GlowDuino/GlowDuino/Uno/Images/IMG_0 (3).JPG

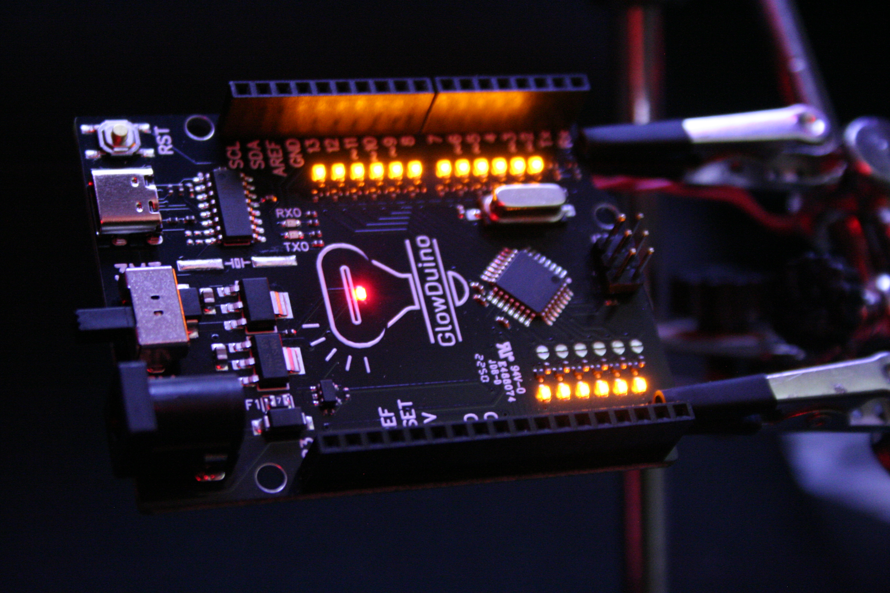
Uno/Images/IMG_0 (3).JPG
