GlowDuino/GlowDuino/Uno/Images/IMG_0 (5).JPG

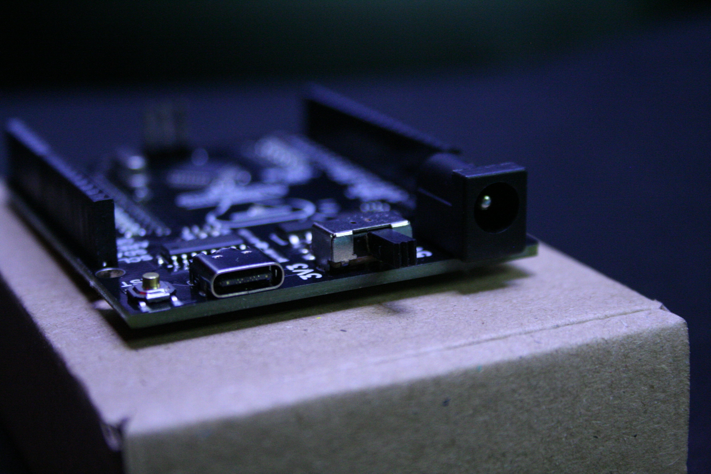
Uno/Images/IMG_0 (5).JPG
