GlowDuino/GlowDuino/Uno/README.md

## UNO Boards

To find more information about your board, reference the version number on the underside 
of your board and open the information folder accordingly!

### General feature overview

- Atmeg 328PB microcontroller
    - 32KB Flash memory
    - 2KB SRAM
    - 1KB EEPROM
    - 16MHz external crystal oscillator
    - 5 Internal timers
    - Preloaded Arduino IDE- compatible bootloader
- 24 GPIO pins
    - 40mA GPIO current
    - 8 Analog inputs (A0- 7)
    - 9 PWM outputs	(0,1,2,3,5,6,9,10,11)
    - 2 Serial ports (0,1, 11,12)
    - 2 I²C interfaces (A5,A4, 22,23)
    - 2 SPI interfaces (10,11,12,13, A0,A1,A6,A7)
- Switchable GPIO voltage (5V, 3.3V)
- High power 5V and 3.3V rail
    - 1A Max
- 20 GPIO indicator LEDs
    - 665K MAX input resistance
- CH340 USB- Serial converter (Serial 0)
- 6pin ICSP header for direct programming
- USB Type- C connector (for programming)
- Power jack (for additional power)
    - Recommended voltage range: 7-12V
    - Maximum voltage range: 6-20V
