GlowDuino/GlowDuino/Uno/v1.7/Bootloader/optiboot/README.txt

We build the bootloaders for the GlowDuino boards using WinAVR-201001110.
