GlowDuino/GlowDuino/Uno/Images/IMG_0 (1).JPG

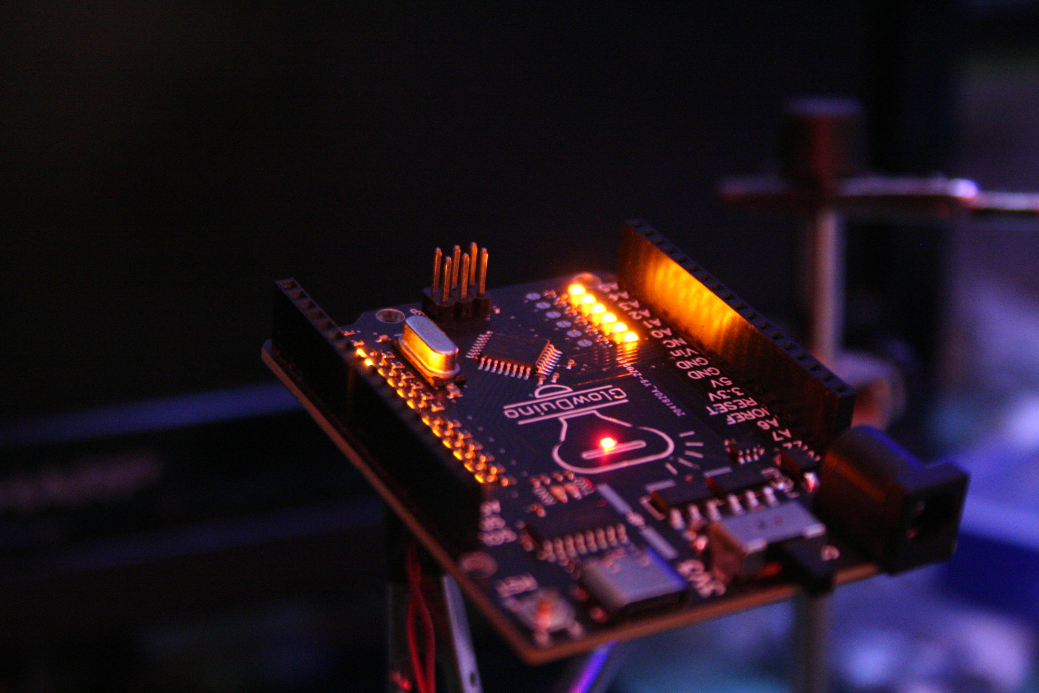
Uno/Images/IMG_0 (1).JPG
