GlowDuino/GlowDuino/Uno/Images/IMG_0 (2).JPG

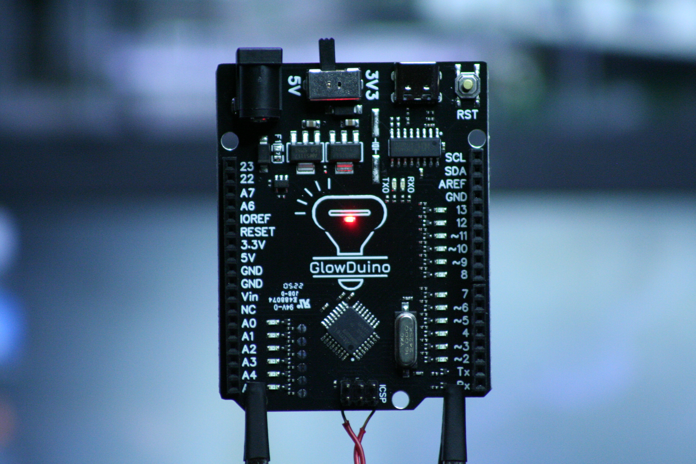
Uno/Images/IMG_0 (2).JPG
