GlowDuino/GlowDuino/Uno/Images/IMG_0 (4).JPG

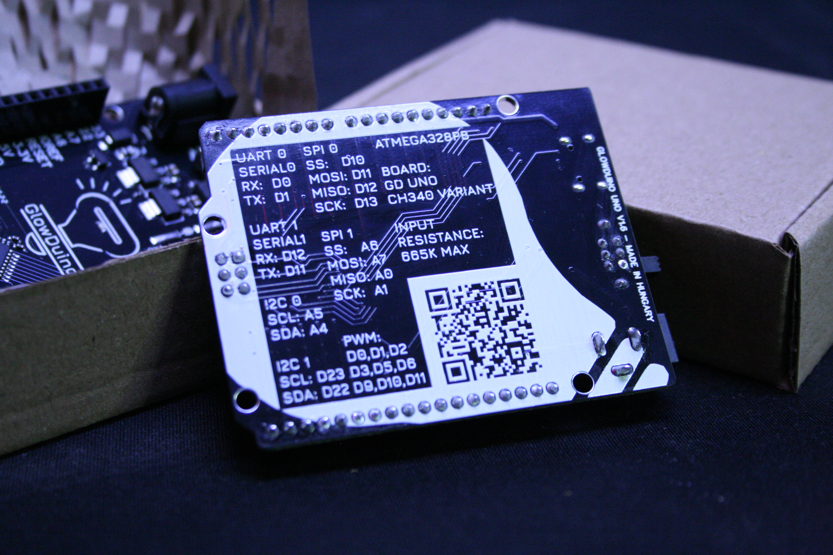
Uno/Images/IMG_0 (4).JPG
