GlowDuino/GlowDuino/Uno/Pinout-UnoV1.6.png

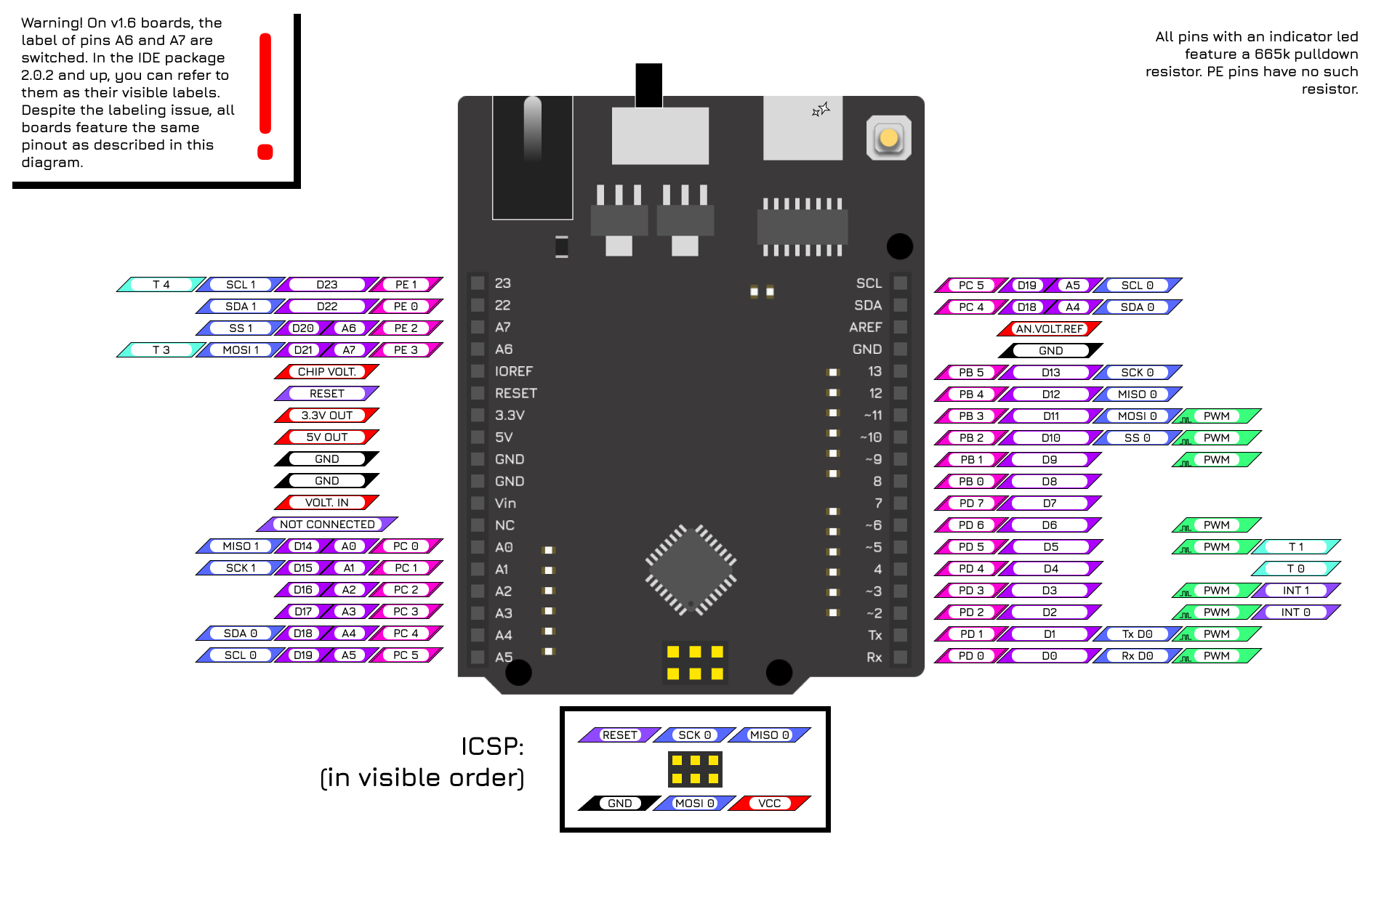
Uno/Pinout-UnoV1.6.png
