GlowDuino/GlowDuino/Uno/Pinout-UnoV1.7 and above.png

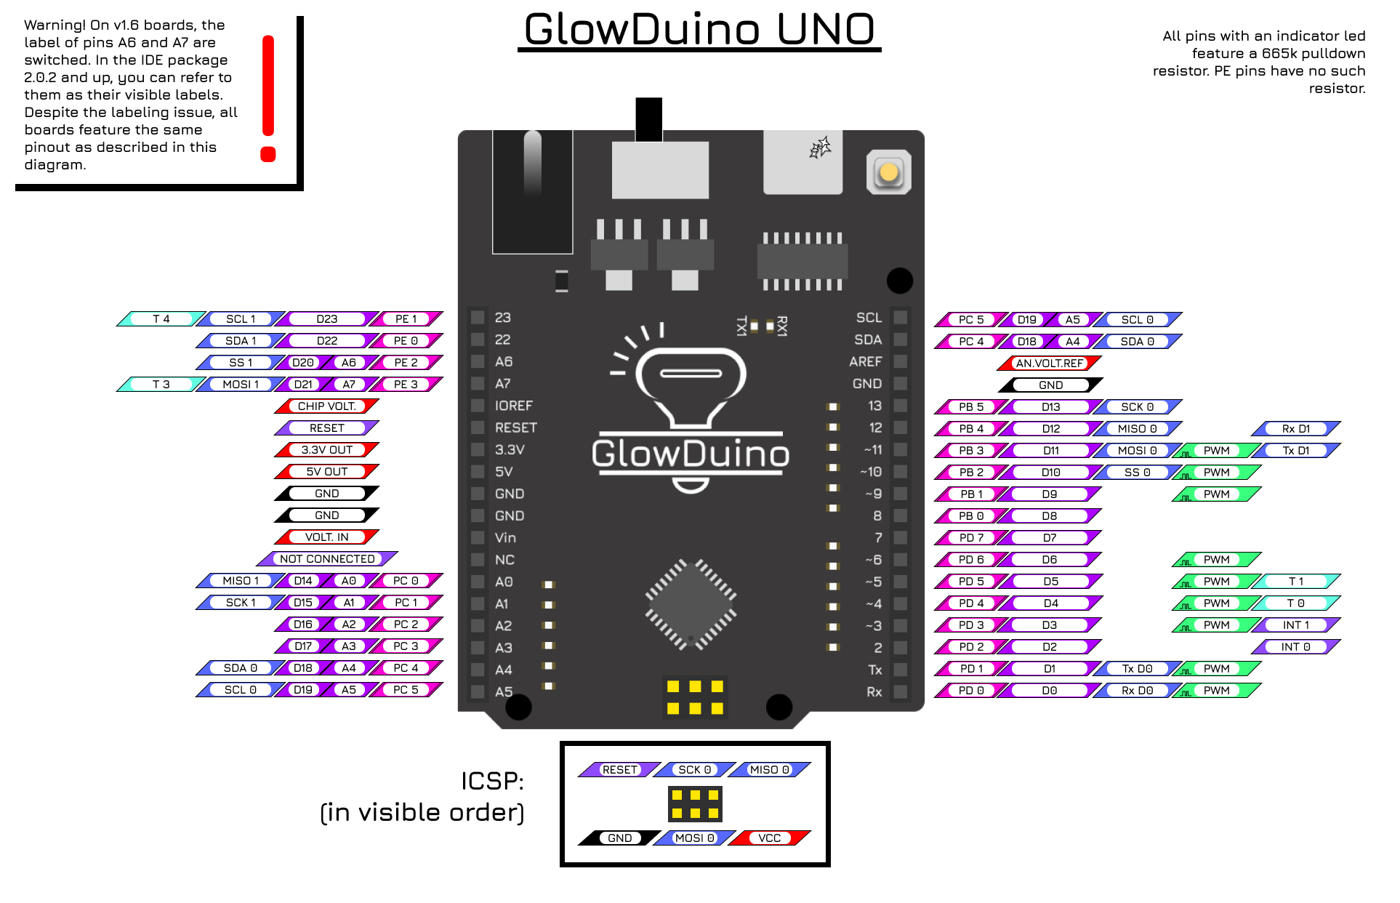
Uno/Pinout-UnoV1.7 and above.png
