GlowDuino/GlowDuino/Uno/v1.7/v1.7_Schematic.png

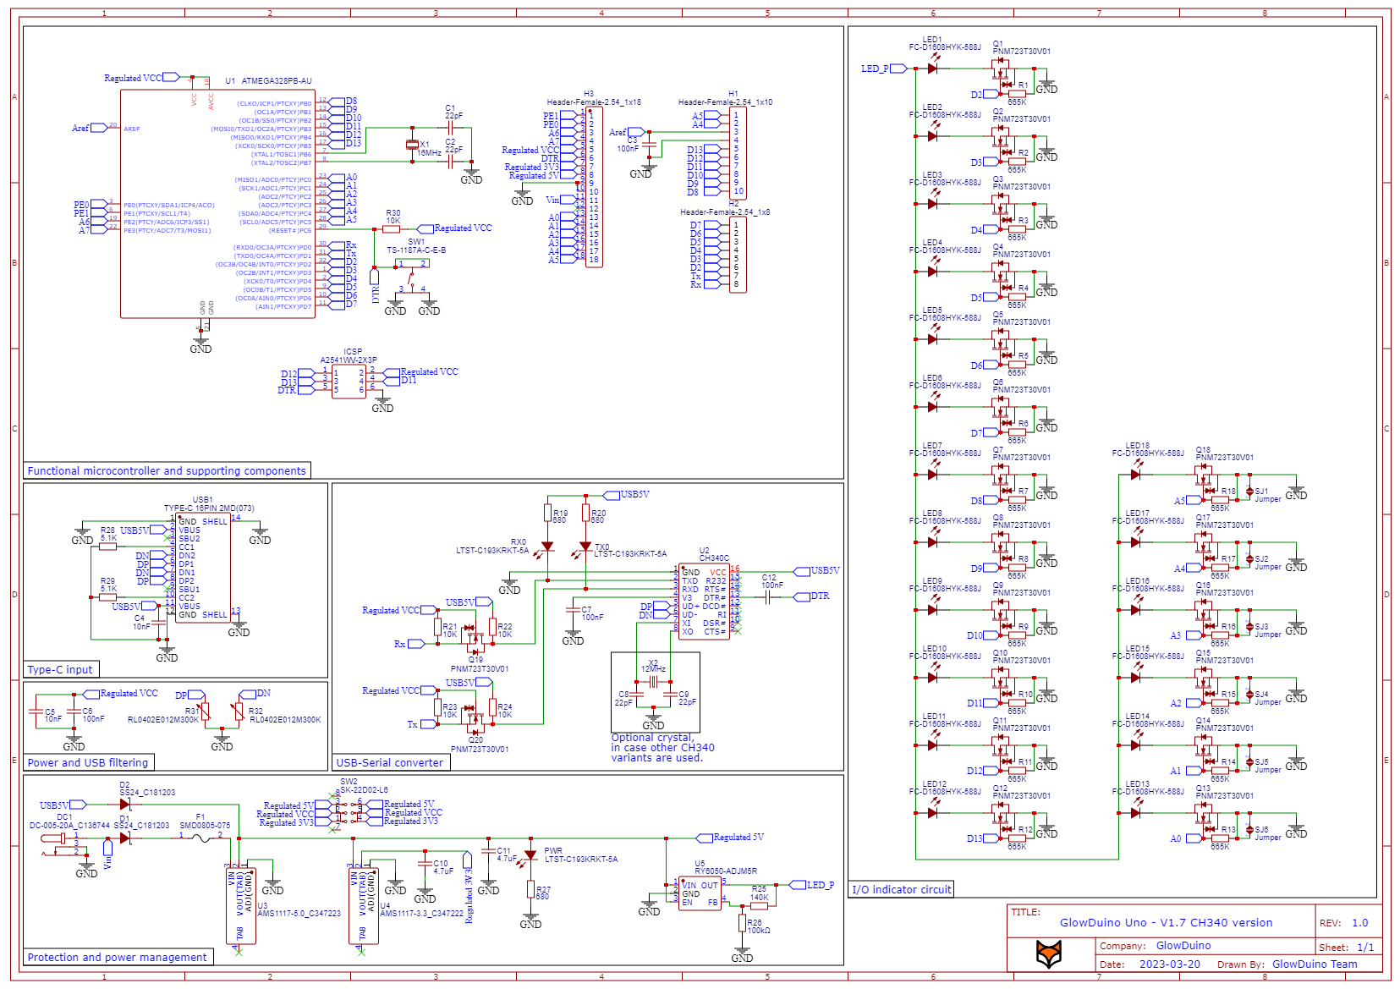
Uno/v1.7/v1.7_Schematic.png
