GlowDuino/GlowDuino/Uno/v1.7/Pin Definitions for C/pins_arduino.h

/*
  pins_arduino.h - Pin definition functions for Arduino
  Part of Arduino - http://www.arduino.cc/

  Copyright (c) 2007 David A. Mellis
  ATmega*PB support jan 2018 by MCUdude

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
  You should have received a copy of the GNU Lesser General
  Public License along with this library; if not, write to the
  Free Software Foundation, Inc., 59 Temple Place, Suite 330,
  Boston, MA  02111-1307  USA
*/

#ifndef Pins_Arduino_h
#define Pins_Arduino_h

#include <avr/pgmspace.h>

#define MINICORE
#define MCUDUDE_MINICORE

// Digital pins
#define NUM_DIGITAL_PINS            (27)

// PWM pins
#if defined(__AVR_ATmega48PB__) || defined(__AVR_ATmega88PB__) || defined(__AVR_ATmega168PB__)
#define digitalPinHasPWM(p)         ((p) == 3 || (p) == 5 || (p) == 6 || (p) == 9 || (p) == 10 || (p) == 11)
#elif defined(__AVR_ATmega328PB__)
#define digitalPinHasPWM(p)         ((p) == 0 || (p) == 1 || (p) == 2 ||(p) == 3 || (p) == 5 || (p) == 6 || (p) == 9 || (p) == 10 || (p) == 11)
#endif

// Builtin LED
#define LED_BUILTIN (13)
static const uint8_t LED = LED_BUILTIN;

// Analog pins
#define PIN_A0 (14)
#define PIN_A1 (15)
#define PIN_A2 (16)
#define PIN_A3 (17)
#define PIN_A4 (18)
#define PIN_A5 (19)
#define PIN_A6 (26)
#define PIN_A7 (25)
static const uint8_t A0 = PIN_A0;
static const uint8_t A1 = PIN_A1;
static const uint8_t A2 = PIN_A2;
static const uint8_t A3 = PIN_A3;
static const uint8_t A4 = PIN_A4;
static const uint8_t A5 = PIN_A5;
static const uint8_t A6 = PIN_A6;
static const uint8_t A7 = PIN_A7;
#define NUM_ANALOG_INPUTS           (8)
#define analogInputToDigitalPin(p)  (((p) < 6) ? ((p) + 14) : (((p) < 8) ? ((p) + 19) : -1))
#define analogPinToChannel(p)       ((p) < NUM_ANALOG_INPUTS ? (p) : ((p) >= 14 && (p) < 25) ? (p) - 14 : ((p) >= 25) ? (p) - 19 : -1)

// SPI
#define PIN_SPI_SS    (10)
#define PIN_SPI_MOSI  (11)
#define PIN_SPI_MISO  (12)
#define PIN_SPI_SCK   (13)
static const uint8_t SS   = PIN_SPI_SS;
static const uint8_t MOSI = PIN_SPI_MOSI;
static const uint8_t MISO = PIN_SPI_MISO;
static const uint8_t SCK  = PIN_SPI_SCK;
#if defined(__AVR_ATmega328PB__)
  #define PIN_SPI_SS0   PIN_SPI_SS
  #define PIN_SPI_MOSI0 PIN_SPI_MOSI
  #define PIN_SPI_MISO0 PIN_SPI_MISO
  #define PIN_SPI_SCK0  PIN_SPI_SCK
  #define PIN_SPI_SS1   (25)
  #define PIN_SPI_MOSI1 (26)
  #define PIN_SPI_MISO1 (14)
  #define PIN_SPI_SCK1  (15)
  static const uint8_t SS0   = PIN_SPI_SS0;
  static const uint8_t MOSI0 = PIN_SPI_MOSI0;
  static const uint8_t MISO0 = PIN_SPI_MISO0;
  static const uint8_t SCK0  = PIN_SPI_SCK0;
  static const uint8_t SS1   = PIN_SPI_SS1;
  static const uint8_t MOSI1 = PIN_SPI_MOSI1;
  static const uint8_t MISO1 = PIN_SPI_MISO1;
  static const uint8_t SCK1  = PIN_SPI_SCK1;
#endif

// i2c
#define PIN_WIRE_SDA  (18)
#define PIN_WIRE_SCL  (19)
static const uint8_t SDA = PIN_WIRE_SDA;
static const uint8_t SCL = PIN_WIRE_SCL;
#if defined(__AVR_ATmega328PB__)
  #define WIRE_INTERFACES_COUNT (2)
  #define PIN_WIRE_SDA0 PIN_WIRE_SDA
  #define PIN_WIRE_SCL0 PIN_WIRE_SCL
  #define PIN_WIRE_SDA1 (23)
  #define PIN_WIRE_SCL1 (24)
  static const uint8_t SDA0  = PIN_WIRE_SDA0;
  static const uint8_t SCL0  = PIN_WIRE_SCL0;
  static const uint8_t SDA1  = PIN_WIRE_SDA1;
  static const uint8_t SCL1  = PIN_WIRE_SCL1;
#endif

// Interrupts
#define EXTERNAL_NUM_INTERRUPTS     (2)
#define digitalPinToInterrupt(p) ((p) == 2 ? 0 : ((p) == 3 ? 1 : NOT_AN_INTERRUPT))

// PCINT
#if defined(__AVR_ATmega48PB__) || defined(__AVR_ATmega88PB__) || defined(__AVR_ATmega168PB__)
#define digitalPinToPCICR(p)     (((p) >= 0 && (p) <= 22) ? (&PCICR) : ((uint8_t *)0))
#define digitalPinToPCICRbit(p)  (((p) <= 7) ? 2 : (((p) <= 13 || (p) == 20 || (p) == 21) ? 0 : 1))
#define digitalPinToPCMSK(p)     (((p) <= 7) ? (&PCMSK2) : (((p) <= 13 || (p) == 20 || (p) == 21) ? (&PCMSK0) : (((p) <= 22) ? (&PCMSK1) : ((uint8_t *)0))))
#define digitalPinToPCMSKbit(p)  (((p) <= 7) ? (p) : (((p) <= 13) ? ((p) - 8) : ((p) <= 21) ? ((p) - 14) : ((p) - 16)))
#elif defined(__AVR_ATmega328PB__)
#define digitalPinToPCICR(p)     (((p) >= 0 && (p) <= 26) ? (&PCICR) : ((uint8_t *)0))
#define digitalPinToPCICRbit(p)  (((p) <= 7) ? 2 : (((p) <= 13 || (p) == 20 || (p) == 21) ? 0 : (((p) <= 22) ? 1 : 3)))
#define digitalPinToPCMSK(p)     (((p) <= 7) ? (&PCMSK2) : (((p) <= 13 || (p) == 20 || (p) == 21) ? (&PCMSK0) : (((p) <= 22) ? (&PCMSK1) : (((p) <= 26) ? (&PCMSK3) : ((uint8_t *)0)))))
#define digitalPinToPCMSKbit(p)  (((p) <= 7) ? (p) : (((p) <= 13) ? ((p) - 8) : ((p) <= 21) ? ((p) - 14) : ((p) == 22) ? ((p) - 16) : ((p) - 23)))
#endif

#define PIN_PD0 0
#define PIN_PD1 1
#define PIN_PD2 2
#define PIN_PD3 3
#define PIN_PD4 4
#define PIN_PD5 5
#define PIN_PD6 6
#define PIN_PD7 7
#define PIN_PB0 8
#define PIN_PB1 9
#define PIN_PB2 10
#define PIN_PB3 11
#define PIN_PB4 12
#define PIN_PB5 13
#define PIN_PC0 14 // A0
#define PIN_PC1 15 // A1
#define PIN_PC2 16 // A2
#define PIN_PC3 17 // A3
#define PIN_PC4 18 // A4
#define PIN_PC5 19 // A5
#define PIN_PB6 20 // XTAL1
#define PIN_PB7 21 // XTAL2
#define PIN_PC6 22 // RESET
#define PIN_PE0 23
#define PIN_PE1 24
#define PIN_PE2 25 // A6
#define PIN_PE3 26 // A7

#ifdef ARDUINO_MAIN

// These arrays map port names (e.g. port B) to the
// appropriate addresses for various functions (e.g. reading
// and writing)
const uint16_t PROGMEM port_to_mode_PGM[] = {
	NOT_A_PORT,
	NOT_A_PORT,
	(uint16_t) &DDRB,
	(uint16_t) &DDRC,
	(uint16_t) &DDRD,
	(uint16_t) &DDRE,
};

const uint16_t PROGMEM port_to_output_PGM[] = {
	NOT_A_PORT,
	NOT_A_PORT,
	(uint16_t) &PORTB,
	(uint16_t) &PORTC,
	(uint16_t) &PORTD,
	(uint16_t) &PORTE,
};

const uint16_t PROGMEM port_to_input_PGM[] = {
	NOT_A_PORT,
	NOT_A_PORT,
	(uint16_t) &PINB,
	(uint16_t) &PINC,
	(uint16_t) &PIND,
	(uint16_t) &PINE,
};

const uint8_t PROGMEM digital_pin_to_port_PGM[] = {
	PD, // PD0 - D0
	PD, // PD1 - D1
	PD, // PD2 - D2
	PD, // PD3 - D3
	PD, // PD4 - D4
	PD, // PD5 - D5
	PD, // PD6 - D6
	PD, // PD7 - D7
	PB, // PB0 - D8
	PB, // PB1 - D9
	PB, // PB2 - D10
	PB, // PB3 - D11
	PB, // PB4 - D12
	PB, // PB5 - D13
	PC, // PC0 - D14 / A0
	PC, // PC1 - D15 / A1
	PC, // PC2 - D16 / A2
	PC, // PC3 - D17 / A3
	PC, // PC4 - D18 / A4
	PC, // PC5 - D19 / A5
	PB, // PB6 - D20 / XTAL1
	PB, // PB7 - D21 / XTAL2
	PC, // PC6 - D22 / RESET
	PE, // PE0 - D23
	PE, // PE1 - D24
	PE, // PE2 - D25 / A6
	PE, // PE3 - D26 / A7
};

const uint8_t PROGMEM digital_pin_to_bit_mask_PGM[] = {
	_BV(0), // PD0 - D0
	_BV(1), // PD1 - D1
	_BV(2), // PD2 - D2
	_BV(3), // PD3 - D3
	_BV(4), // PD4 - D4
	_BV(5), // PD5 - D5
	_BV(6), // PD6 - D6
	_BV(7), // PD7 - D7
	_BV(0), // PB0 - D8
	_BV(1), // PB1 - D9
	_BV(2), // PB2 - D10
	_BV(3), // PB3 - D11
	_BV(4), // PB4 - D12
	_BV(5), // PB5 - D13
	_BV(0), // PC0 - D14 / A0
	_BV(1), // PC1 - D15 / A1
	_BV(2), // PC2 - D16 / A2
	_BV(3), // PC3 - D17 / A3
	_BV(4), // PC4 - D18 / A4
	_BV(5), // PC5 - D19 / A5
	_BV(6), // PB6 - D20 / XTAL1
	_BV(7), // PB7 - D21 / XTAL2
	_BV(6), // PC6 - D22 / RESET
	_BV(0), // PE0 - D23
	_BV(1), // PE1 - D24
	_BV(2), // PE2 - D25 / A6
	_BV(3), // PE3 - D26 / A7
};

const uint8_t PROGMEM digital_pin_to_timer_PGM[] = {
#if defined(__AVR_ATmega48PB__) || defined(__AVR_ATmega88PB__) || defined(__AVR_ATmega168PB__)
	NOT_ON_TIMER, // PD0 - D0
	NOT_ON_TIMER, // PD1 - D1
	NOT_ON_TIMER, // PD2 - D2
#elif	defined(__AVR_ATmega328PB__)
  TIMER3A,      // PD0 - D0
	TIMER4A,      // PD1 - D1
	TIMER4B,      // PD2 - D2 -> TIMER3B is also an option
#endif
	TIMER2B,      // PD3 - D3
	NOT_ON_TIMER, // PD4 - D4
	TIMER0B,      // PD5 - D5
	TIMER0A,      // PD6 - D6
	NOT_ON_TIMER, // PD7 - D7
	NOT_ON_TIMER, // PB0 - D8
	TIMER1A,      // PB1 - D9
	TIMER1B,      // PB2 - D10
	TIMER2A,      // PB3 - D11
	NOT_ON_TIMER, // PB4 - D12
	NOT_ON_TIMER, // PB5 - D13
	NOT_ON_TIMER, // PC0 - D14 / A0
	NOT_ON_TIMER, // PC1 - D15 / A1
	NOT_ON_TIMER, // PC2 - D16 / A2
	NOT_ON_TIMER, // PC3 - D17 / A3
	NOT_ON_TIMER, // PC4 - D18 / A4
	NOT_ON_TIMER, // PC5 - D19 / A5
	NOT_ON_TIMER, // PB6 - D20 / XTAL1
	NOT_ON_TIMER, // PB7 - D21 / XTAL2
	NOT_ON_TIMER, // PC6 - D22 / RESET
	NOT_ON_TIMER, // PE0 - D23
	NOT_ON_TIMER, // PE1 - D24
	NOT_ON_TIMER, // PE2 - D25 / A6
	NOT_ON_TIMER, // PE3 - D26 / A7
};

#endif // ARDUINO_MAIN

// Make sure the ATmega328PB is backwards compatible with the 328 and 328P
#if defined(__AVR_ATmega328PB__)
// SPI
  #define SPCR SPCR0
  #define SPSR SPSR0
  #define SPDR SPDR0
  #define SPI_STC_vect SPI0_STC_vect
  #define SPI_STC_vect_num SPI0_STC_vect_num
// I2C
  #define TWBR TWBR0
  #define TWSR TWSR0
  #define TWAR TWAR0
  #define TWDR TWDR0
  #define TWCR TWCR0
  #define TWAMR TWAMR0
  #define TWI_vect TWI0_vect
  #define TWI_vect_num TWI0_vect_num
// UART
  #define USART_RX_vect USART0_RX_vect
  #define USART_RX_vect_num USART0_RX_vect_num
  #define USART_UDRE_vect USART0_UDRE_vect
  #define USART_UDRE_vect_num USART0_UDRE_vect_num
  #define USART_TX_vect USART0_TX_vect
  #define USART_TX_vect_num USART0_TX_vect_num
#endif // 328PB defs

// These serial port names are intended to allow libraries and architecture-neutral
// sketches to automatically default to the correct port name for a particular type
// of use.  For example, a GPS module would normally connect to SERIAL_PORT_HARDWARE_OPEN,
// the first hardware serial port whose RX/TX pins are not dedicated to another use.

#define SERIAL_PORT_MONITOR         Serial
#define SERIAL_PORT_HARDWARE        Serial
#define SERIAL_PORT_HARDWARE_OPEN   Serial

#if defined(__AVR_ATmega328PB__)
#define SERIAL_PORT_HARDWARE1       Serial1
#define SERIAL_PORT_HARDWARE_OPEN1  Serial1
#endif

#endif // Pins_Arduino_h
