GlowDuino/GlowDuino/(commit log)

2022-11-08 Driver package
    CH340 drivers for all OS
2023-03-03 Schematic correction
2023-03-24 Full Function Update
    MiniCore port for the GlowDuino Uno board.
2023-07-03 Example sketch update
    Added pong game and corrected LED fader program.
    [Pong Game.ino, Random LED Fader.ino]
2023-07-28 Uno v1.7 release
    Release files and updates for the Uno 1.7 board.
2023-08-15 Pinout image update
    Refreshed and informative pinout diagram for the Uno board.
2024-01-18 Update to package_GlowDuino_index.json
    Simple error correction for compatibility with newer versions of Arduino IDE
2025-10-30 Updated IDE package for Arduino IDE 2.0
